AlphaLED/board/photos/v23.10.01/3d.png

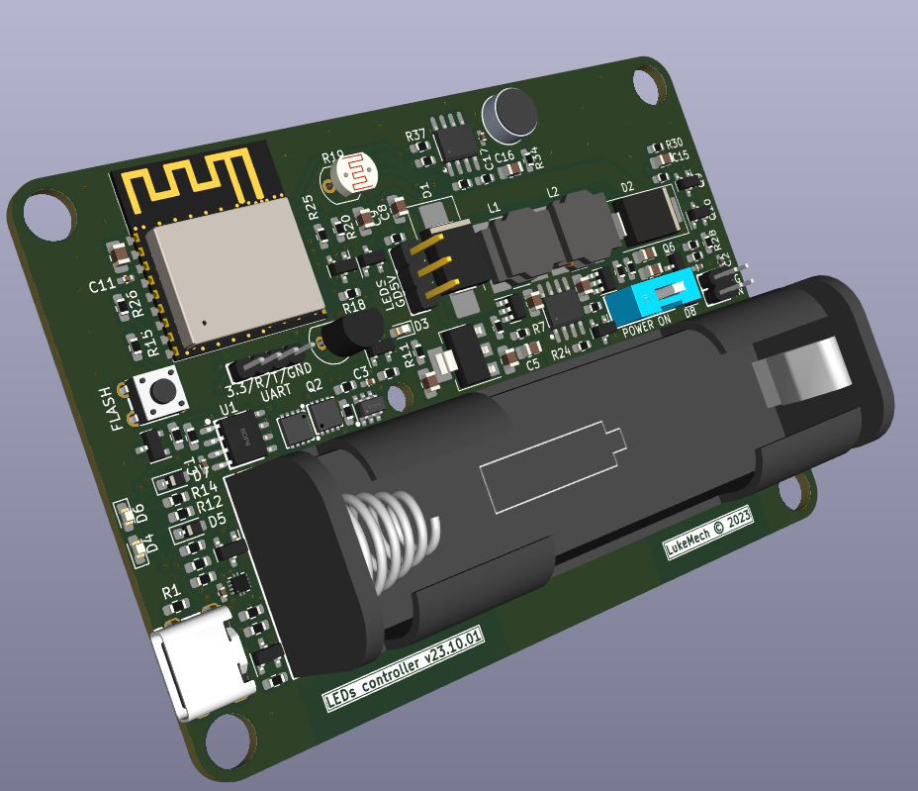
photos/v23.10.01/3d.png
