AlphaLED/board/photos/v23.10.01/board.png

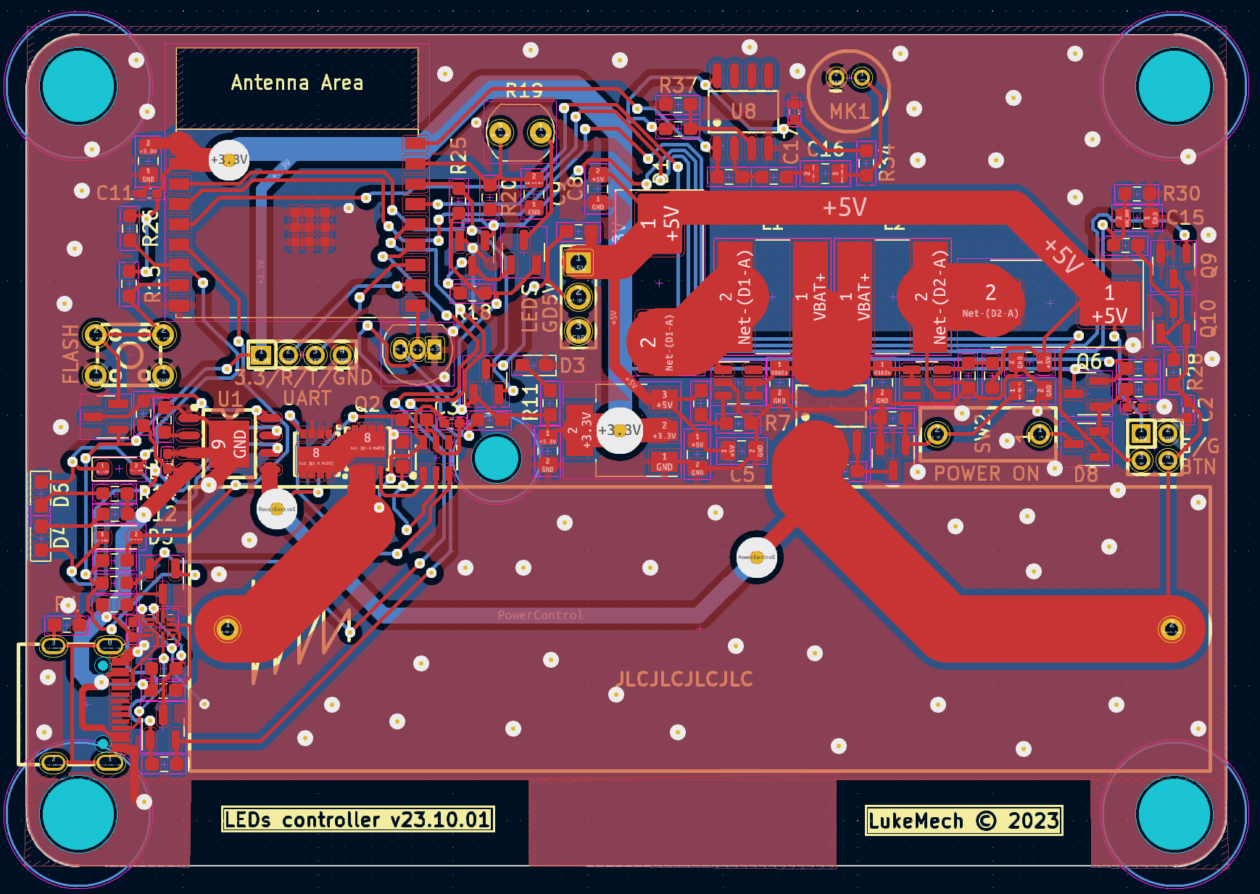
photos/v23.10.01/board.png
