AlphaLED/board/photos/v23.10.01/circuit.png

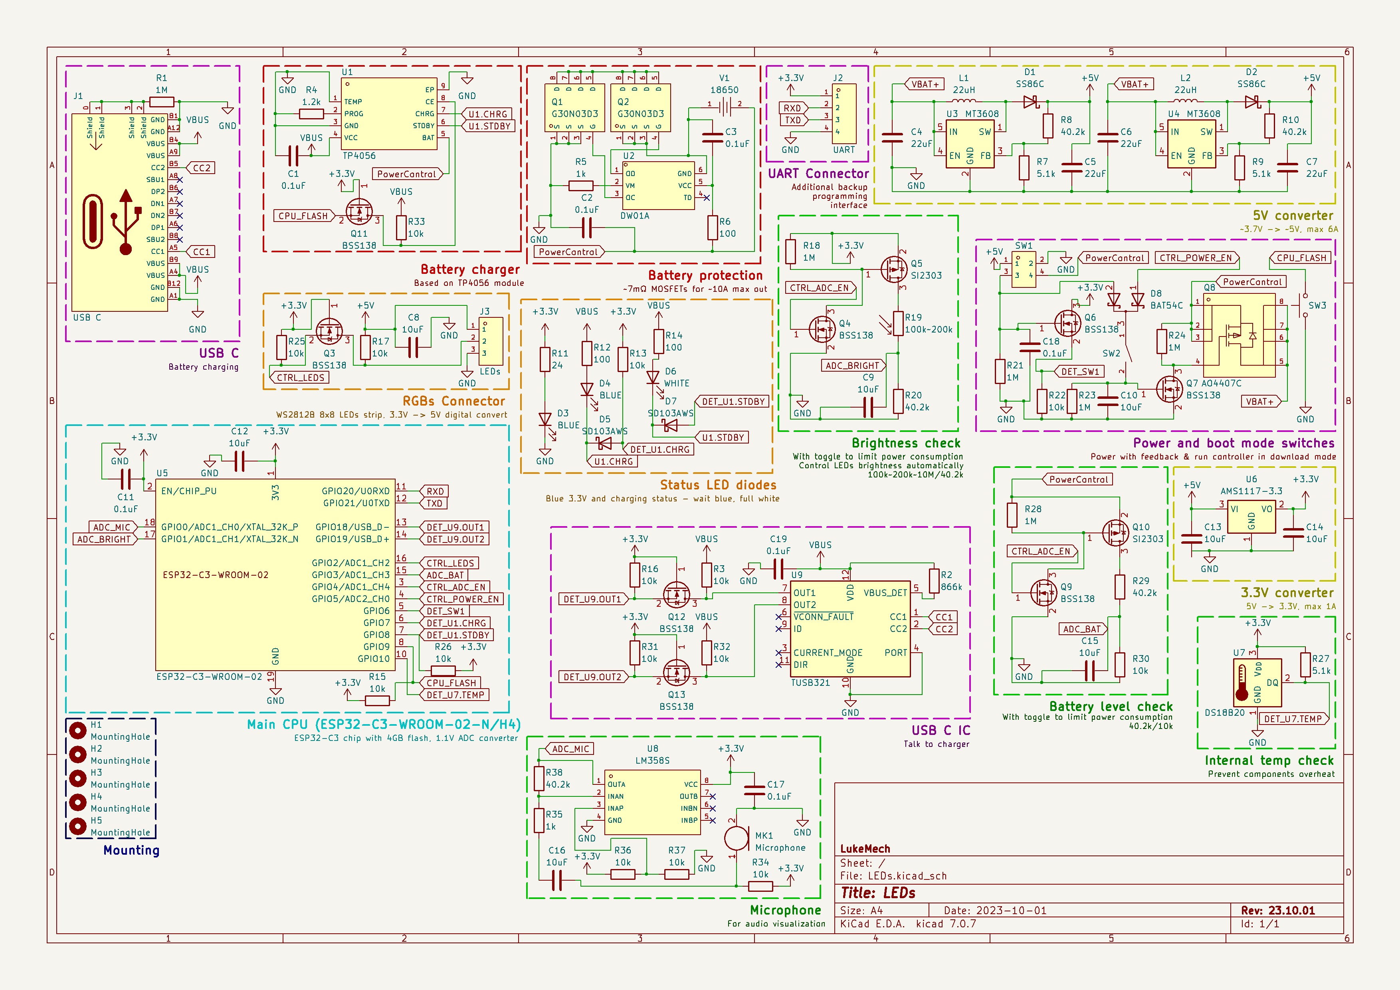
photos/v23.10.01/circuit.png
