AlphaLED/board/parts.xlsx

Name | Value | Amount | LCSC Number | Additional info | ! € -> PLN
Resistor | 1M | 6 | C103216 | - | 4.7
 | 866k | 1 | C5126056 | -
 | 40.2k | 5 | C12447 | - | ! JLCPCB total price (€)
 | 10k | 15 | C103210 | - | 41.07
 | 5.1k | 3 | C2907114 | -
 | 1.2k | 1 | C2907081 | - | ! LCSC total price (€)
 | 1k | 2 | C3016283 | - | 50
 | 100 | 3 | C3017758 | -
 | 24 | 1 | C3017772 | - | ! Price for amount
 | 100k~200k | 1 | C125631 | Photoresistor | 5
 | (FN) Sum | 38 | - | -
Capacitor | 22uF | 4 | C98190 | - | (FN) Calculated price per 1 (PLN)
 | 10uF | 8 | C1713 | - | 116.3558
 | 0.1uF | 7 | C344189 | -
 | (FN) Sum | 19
Inductors | 22uH | 2 | C2942298 | -
 | (FN) Sum | 2
Diodes | White | 1 | C965808 | -
 | Blue | 2 | C965807 | -
 | SS86C | 2 | C382823 | -
 | BAT54C | 1 | C2992451 | -
 | SD103AWS | 2 | C513472 | -
 | (FN)Sum | 8
MOSFET Transistors | G30N03D3 | 2 | C840054 | N-channel 30V 30A
 | BSS138 | 8 | C347484 | N-channel 50V 0.2A
 | SI2303 | 2 | C545575 | P-channel 30V 1.7A
 | AO4407C | 1 | C469397 | P-channel 30V 14A
 | (FN) Sum | 13
Logic boards | ESP32-C3 -WROOM | 1 | C2944070 | Main CPU
 | TP4056 | 1 | C7473158 | Battery charger IC
 | DW01A | 1 | C351410 | Battery protection IC
 | MT3608 | 2 | C2932326 | Voltage regulator -> FB 0.6*(1+R1/R2)
 | AMS1117-3.3 | 1 | C5181460 | 3.3V voltage regulator
 | DS18B20 | 1 | C5379069 | Temperature sensor
 | LM358S | 1 | C83902 | Dual amplifier
 | TUSB321 | 1 | C139392 | USB Type-C Configuration Channel IC
 | Condenser Microphone | 1 | C5160215 | Microphone
 | (FN) Sum | 10
Connectors | USB-C | 1 | C2927038 | -
 | 4pin UART | 1 | C541858 | -
 | 3pin LEDs | 1 | C429954 | -
 | 4pin power | 1 | C6332216 | -
 | Battery (18650) holder | 1 | C5290176 | -
Switches | DIP NC Power | 1 | C5299502 | -
 | Flash tactile switch | 1 | C5359331 | -
Third party | - | - | - | Price per unit (PLN)
 | Power button | 1 | - | 5
 | LEDs | 1 | - | 11.45
 | 18650 battery | 1 | - | 14.3
