AlphaLED/board/case/2-n.stl

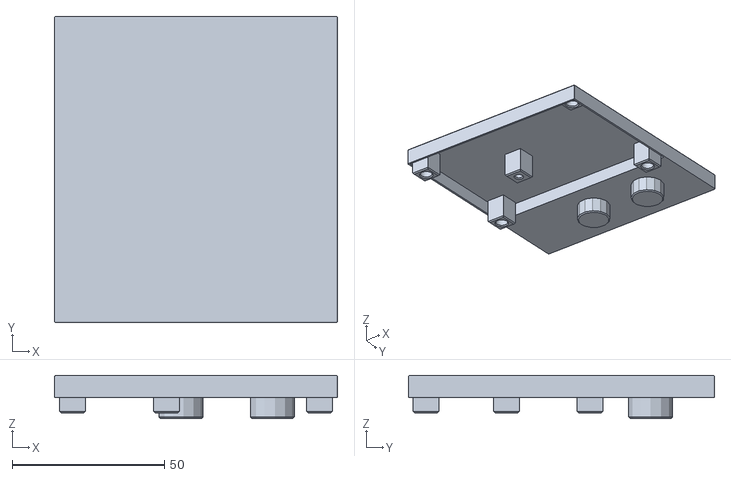
[picture p4: CAD file, 2023-10-01]
case/2-n.stl
93.0 x 100.7 x 14.2
