AlphaLED/board/case/1-n.stl

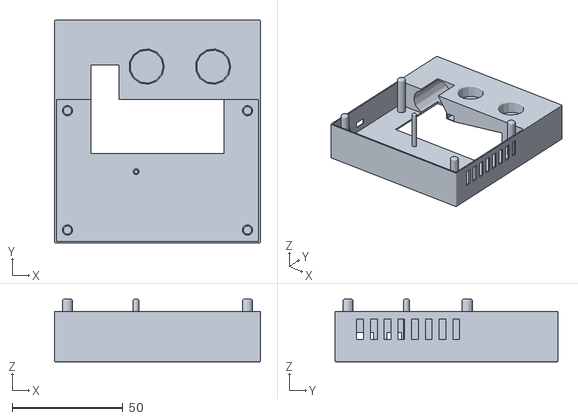
[picture p5: CAD file, 2023-10-01]
case/1-n.stl
93.0 x 100.7 x 28.3
