AlphaLED/board/LEDs.kicad_pcb

## KiCad design LEDs.kicad_pcb (2023-10-26)

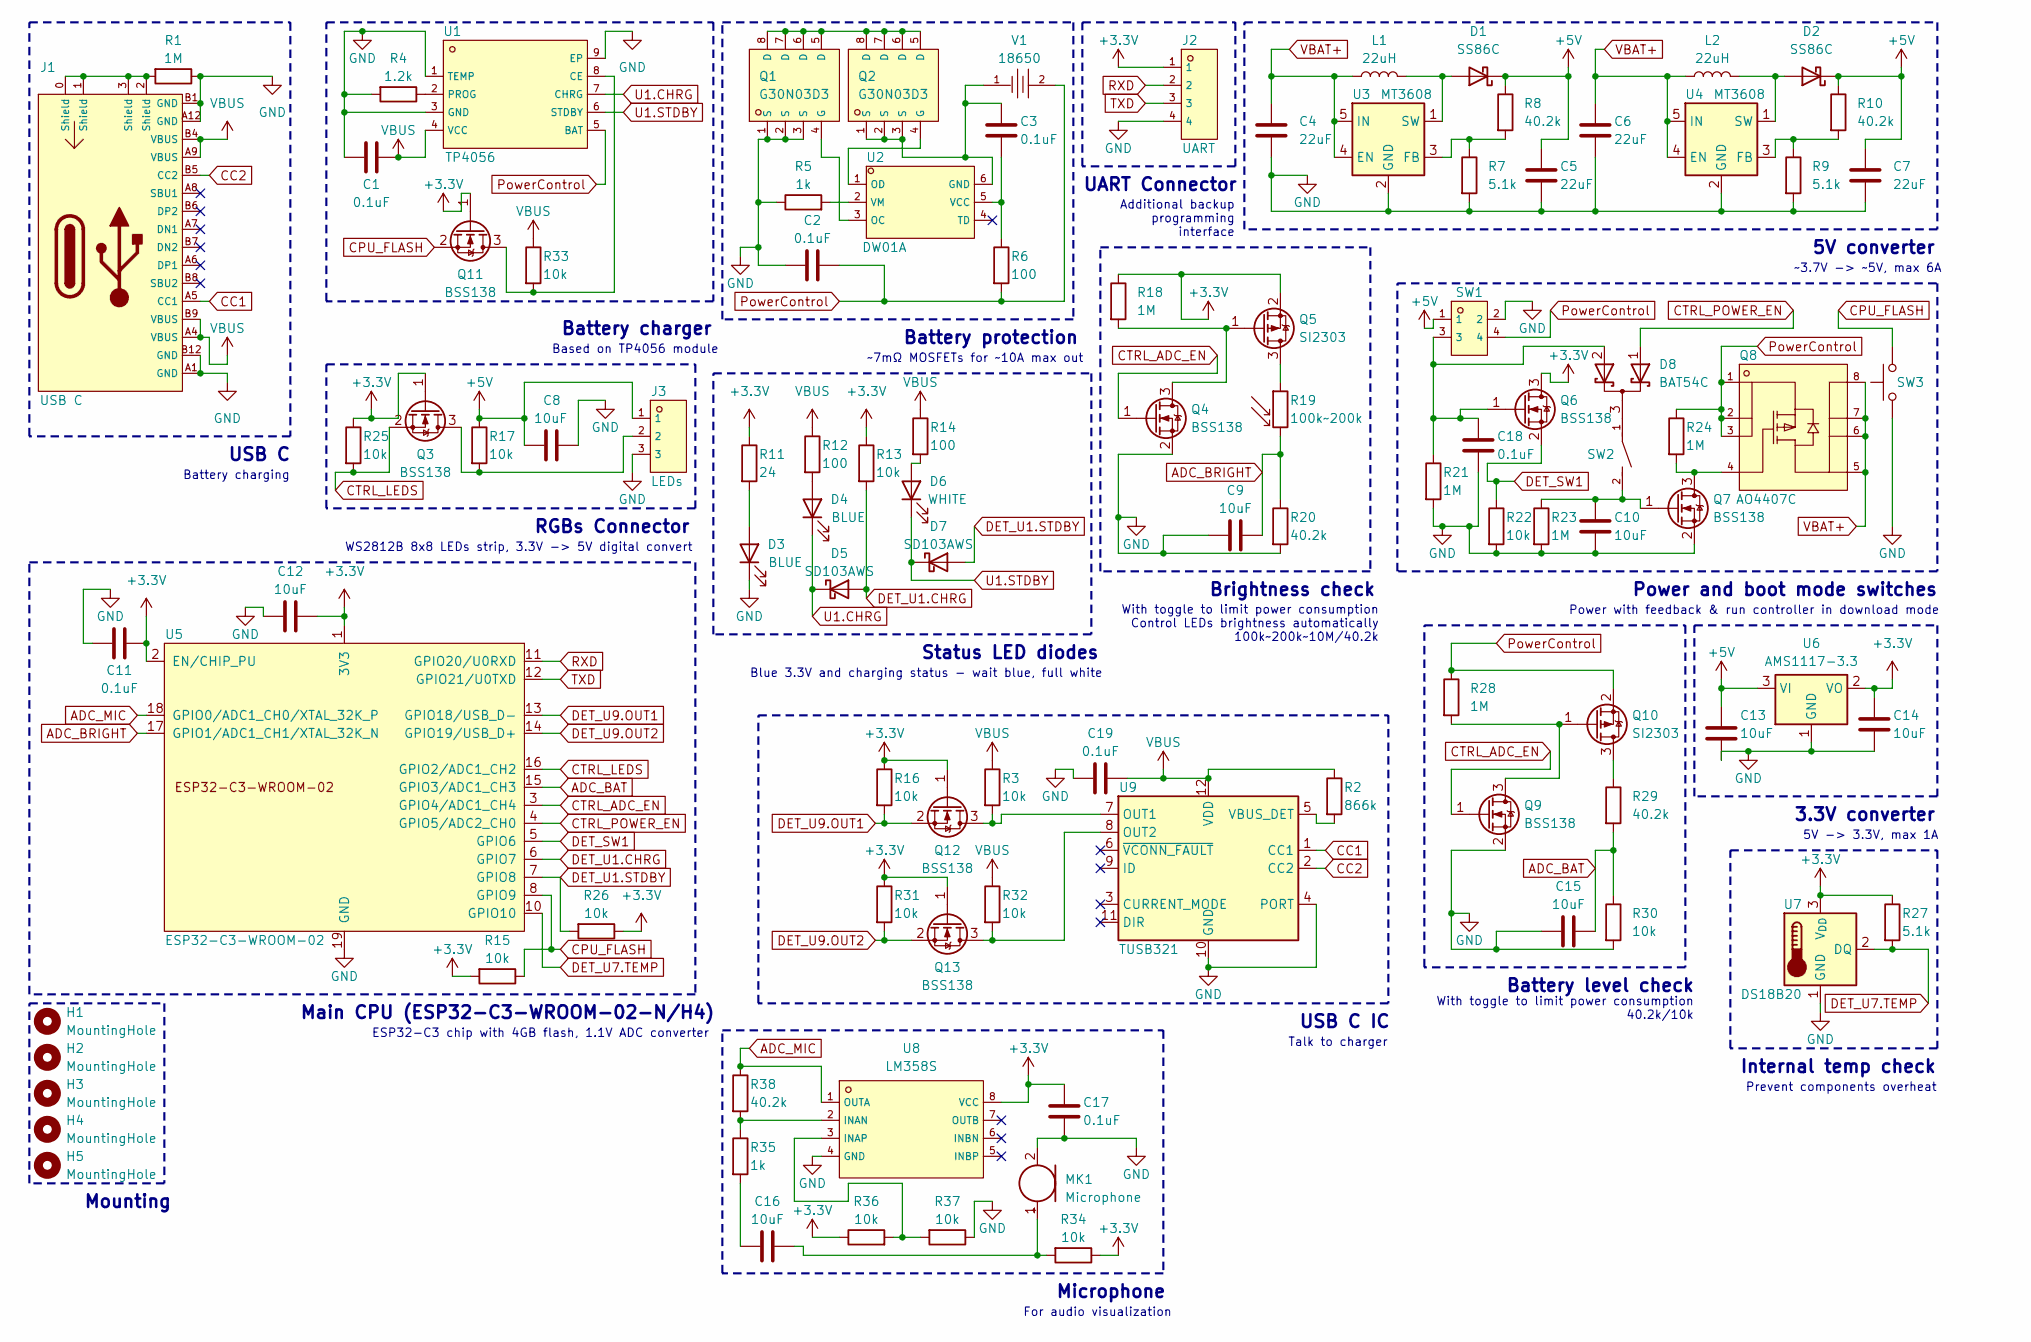
[picture p6: schematic LEDs.kicad_sch]

Parts:
C1, C2, C3, C11, C17, C18, C19: 0.1uF; C_0402_1005Metric_Pad0.74x0.62mm_HandSolder; LCSC C344189
C4, C5, C6, C7: 22uF; C_0805_2012Metric_Pad1.18x1.45mm_HandSolder; LCSC C98190
C8, C9, C10, C12, C13, C14, C15, C16: 10uF; C_0805_2012Metric_Pad1.18x1.45mm_HandSolder; LCSC C1713
D1, D2: SS86C; D_SMC_Handsoldering; LCSC C382823
D3, D4: BLUE; LED_0603_1608Metric_Pad1.05x0.95mm_HandSolder; LCSC C965807
D5, D7: SD103AWS; D_SOD-323_HandSoldering; LCSC C513472
D6: WHITE; LED_0603_1608Metric_Pad1.05x0.95mm_HandSolder; LCSC C965808
D8: BAT54C; SOT-23; LCSC C2992451
H1, H2, H3, H4: MountingHole; MountingHole_5.3mm_M5
H5: MountingHole; MountingHole_3.2mm_M3
J1: USB C; USB-C_SMD-TYPE-C-31-M-12; LCSC C2927038
J2: UART; HDR-TH_4P-P2.00-V-M; LCSC C541858
J3: LEDs; HDR-TH_3P-P2.54-V-M-1; LCSC C429954
L1, L2: 22uH; L_Bourns-SRN8040_8x8.15mm; LCSC C2942298
MK1: Microphone; MIC-TH_BD6.0_B6027AP383-056; LCSC C5160215
Q1, Q2: G30N03D3; POWERVDFN-8_L3.2-W3.1-P0.65-LS3.3-BL-1; LCSC C840054
Q3, Q4, Q6, Q7, Q9, Q11, Q12, Q13: BSS138; SOT-23; LCSC C347484
Q5, Q10: SI2303; SOT-23; LCSC C545575
Q8: AO4407C; SOP-8_L4.9-W3.9-P1.27-LS6.0-BL; LCSC C469397
R1, R18, R21, R23, R24, R28: 1M; R_0603_1608Metric_Pad0.98x0.95mm_HandSolder; LCSC C103216
R2: 866k; R_0603_1608Metric_Pad0.98x0.95mm_HandSolder; LCSC C5126056
R3, R13, R15, R16, R17, R22, R25, R26, R30, R31, R32, R33, R34, R36, R37: 10k; R_0603_1608Metric_Pad0.98x0.95mm_HandSolder; LCSC C103210
R4: 1.2k; R_0603_1608Metric_Pad0.98x0.95mm_HandSolder; LCSC C2907081
R5, R35: 1k; R_0603_1608Metric_Pad0.98x0.95mm_HandSolder; LCSC C3016283
R6, R12, R14: 100; R_0603_1608Metric_Pad0.98x0.95mm_HandSolder; LCSC C3017758
R7, R9, R27: 5.1k; R_0603_1608Metric_Pad0.98x0.95mm_HandSolder; LCSC C2907114
R8, R10, R20, R29, R38: 40.2k; R_0603_1608Metric_Pad0.98x0.95mm_HandSolder; LCSC C12447
R11: 24; R_0603_1608Metric_Pad0.98x0.95mm_HandSolder; LCSC C3017772
R19: 100k~200k; R_LDR_5.0x4.1mm_P3mm_Vertical; LCSC C125631
SW1: 4-pin; HDR-TH_4P-P2.00-V-M-R2-C2-S2.00; LCSC C6332216
SW2: SW-TH_KF1001-01P-B0-FL-ON-01B; LCSC C5299502
SW3: SW-TH_4P-L4.5-W4.5-P3.00-LS5.0; LCSC C5359331
U1: TP4056; SOP-8_L4.9-W3.9-P1.27-LS6.0-TL-EP; LCSC C7473158
U2: DW01A; SOT-23-6_L2.9-W1.6-P0.95-LS2.8-BL; LCSC C351410
U3, U4: MT3608; SOT-23-6; LCSC C2932326
U5: ESP32-C3-WROOM-02; LCSC C2944070
U6: AMS1117-3.3; SOT-223-3_TabPin2; LCSC C5181460
U7: DS18B20; TO-92_Inline; LCSC C5379069
U8: LM358S; SOP-8_L4.9-W3.9-P1.27-LS6.0-BL; LCSC C83902
U9: TUSB321; Texas_X2QFN-12_1.6x1.6mm_P0.4mm; LCSC C139392
V1: 18650; BAT-TH_BH-18650-A1AJ005; LCSC C5290176

Connections:
+3.3V: C11.2, C12.2, C14.1, C17.1, J2.1, Q3.1 (G), Q5.2 (S), Q6.3 (D), Q11.1 (G), Q12.1 (G), Q13.1 (G), R11.1, R13.1, R15.2, R16.1, R18.1, R25.1, R26.1, R27.1, R31.1, R34.1, R36.1, U5.1 (3V3), U5.2 (EN/CHIP_PU), U6.2 (VO), U7.3 (V_{DD}), U8.8 (VCC)
+5V: C5.1, C7.1, C8.2, C13.1, D1.1 (K), D2.1 (K), J3.1, R8.1, R10.1, R17.1, SW1.1, U6.3 (VI)
ADC_BAT: C15.2, R29.2, R30.1, U5.15 (GPIO3/ADC1_CH3)
ADC_BRIGHT: C9.2, R19.2, R20.1, U5.17 (GPIO1/ADC1_CH1/XTAL_32K_N)
ADC_MIC: R38.1, U5.18 (GPIO0/ADC1_CH0/XTAL_32K_P), U8.1 (OUTA)
CC1: J1.A5 (CC1), U9.1 (CC1)
CC2: J1.B5 (CC2), U9.2 (CC2)
CTRL_ADC_EN: Q4.1 (G), Q9.1 (G), U5.3 (GPIO4/ADC1_CH4)
CTRL_LEDS: Q3.2 (S), R25.2, U5.16 (GPIO2/ADC1_CH2)
CTRL_POWER_EN: D8.1 (K), U5.4 (GPIO5/ADC2_CH0)
DET_SW1: Q6.2 (S), R22.1, U5.5 (GPIO6)
DET_U1.CHRG: D5.2 (A), R13.2, U5.6 (GPIO7)
DET_U1.STDBY: D7.2 (A), R26.2, U5.7 (GPIO8)
DET_U7.TEMP: R27.2, U5.10 (GPIO10), U7.2 (DQ)
DET_U9.OUT1: Q12.2 (S), R16.2, U5.13 (GPIO18/USB_D-)
DET_U9.OUT2: Q13.2 (S), R31.2, U5.14 (GPIO19/USB_D+)
unnamed: C16.2, R35.2
unnamed: D1.2 (A), L1.2, U3.1 (SW)
unnamed: D2.2 (A), L2.2, U4.1 (SW)
unnamed: D3.2 (A), R11.2
unnamed: D4.2 (A), R12.2
unnamed: D6.2 (A), R14.2
unnamed: D8.3 (A), SW2.1
unnamed: J1.0 (Shield), J1.1 (Shield), J1.2 (Shield), J1.3 (Shield), R1.2
unnamed: C16.1, MK1.1 (+), R34.2
unnamed: Q1.5 (D), Q1.6 (D), Q1.7 (D), Q1.8 (D), Q2.5 (D), Q2.6 (D), Q2.7 (D), Q2.8 (D)
unnamed: Q1.4 (G), U2.3 (OC)
unnamed: Q2.4 (G), U2.1 (OD)
unnamed: J3.2, Q3.3 (D), R17.2
unnamed: Q4.3 (D), Q5.1 (G), R18.2
unnamed: Q5.3 (D), R19.1
unnamed: C18.1, D8.2 (K), Q6.1 (G), R21.1, SW1.3
unnamed: Q7.3 (D), Q8.4 (G), R24.2
unnamed: C10.1, Q7.1 (G), R23.1, SW2.2
unnamed: Q10.3 (D), R29.1
unnamed: Q9.3 (D), Q10.1 (G), R28.2
unnamed: Q11.3 (D), R33.2, U1.8 (CE)
unnamed: Q12.3 (D), R3.2, U9.7 (OUT1)
unnamed: Q13.3 (D), R32.2, U9.8 (OUT2)
unnamed: R4.1, U1.2 (PROG)
unnamed: C3.1, Q2.1 (S), Q2.2 (S), Q2.3 (S), U2.6 (GND), V1.1
unnamed: C3.2, R6.1, U2.5 (VCC)
unnamed: R5.2, U2.2 (VM)
unnamed: R7.1, R8.2, U3.3 (FB)
unnamed: R9.1, R10.2, U4.3 (FB)
unnamed: R35.1, R38.2, U8.2 (INAN)
unnamed: R36.2, R37.2, U8.3 (INAP)
unnamed: R2.2, U9.5 (VBUS_DET)
PowerControl: C2.2, Q8.1 (S), Q8.2 (S), Q8.3 (S), Q10.2 (S), R6.2, R24.1, R28.1, SW1.4, U1.5 (BAT), V1.2
RXD: J2.2, U5.11 (GPIO20/U0RXD)
TXD: J2.3, U5.12 (GPIO21/U0TXD)
U1.CHRG: D4.1 (K), D5.1 (K), U1.7 (CHRG)
U1.STDBY: D6.1 (K), D7.1 (K), U1.6 (STDBY)
VBAT+: C4.1, C6.1, L1.1, L2.1, Q8.5 (D), Q8.6 (D), Q8.7 (D), Q8.8 (D), U3.4 (EN), U3.5 (IN), U4.4 (EN), U4.5 (IN)
VBUS: C1.2, C19.2, J1.A4 (VBUS), J1.A9 (VBUS), J1.B4 (VBUS), J1.B9 (VBUS), R2.1, R3.1, R12.1, R14.1, R32.1, R33.1, U1.4 (VCC), U9.12 (VDD)

Notes on the sheet:
Internal temp check
With toggle to limit power consumption Control LEDs brightness automatically 100k~200k~10M/40.2k
USB C
Battery level check
Prevent components overheat
Power with feedback & run controller in download mode
Main CPU (ESP32-C3-WROOM-02-N/H4)
Brightness check
Microphone
Blue 3.3V and charging status - wait blue, full white
WS2812B 8x8 LEDs strip, 3.3V -> 5V digital convert
3.3V converter
RGBs Connector
Battery protection
Status LED diodes
Talk to charger
5V -> 3.3V, max 1A
Battery charging
~7mΩ MOSFETs for ~10A max out
ESP32-C3 chip with 4GB flash, 1.1V ADC converter
Mounting
USB C IC
Power and boot mode switches
5V converter
Battery charger
Based on TP4056 module
UART Connector
Additional backup programming interface
~3.7V -> ~5V, max 6A
With toggle to limit power consumption 40.2k/10k
For audio visualization

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
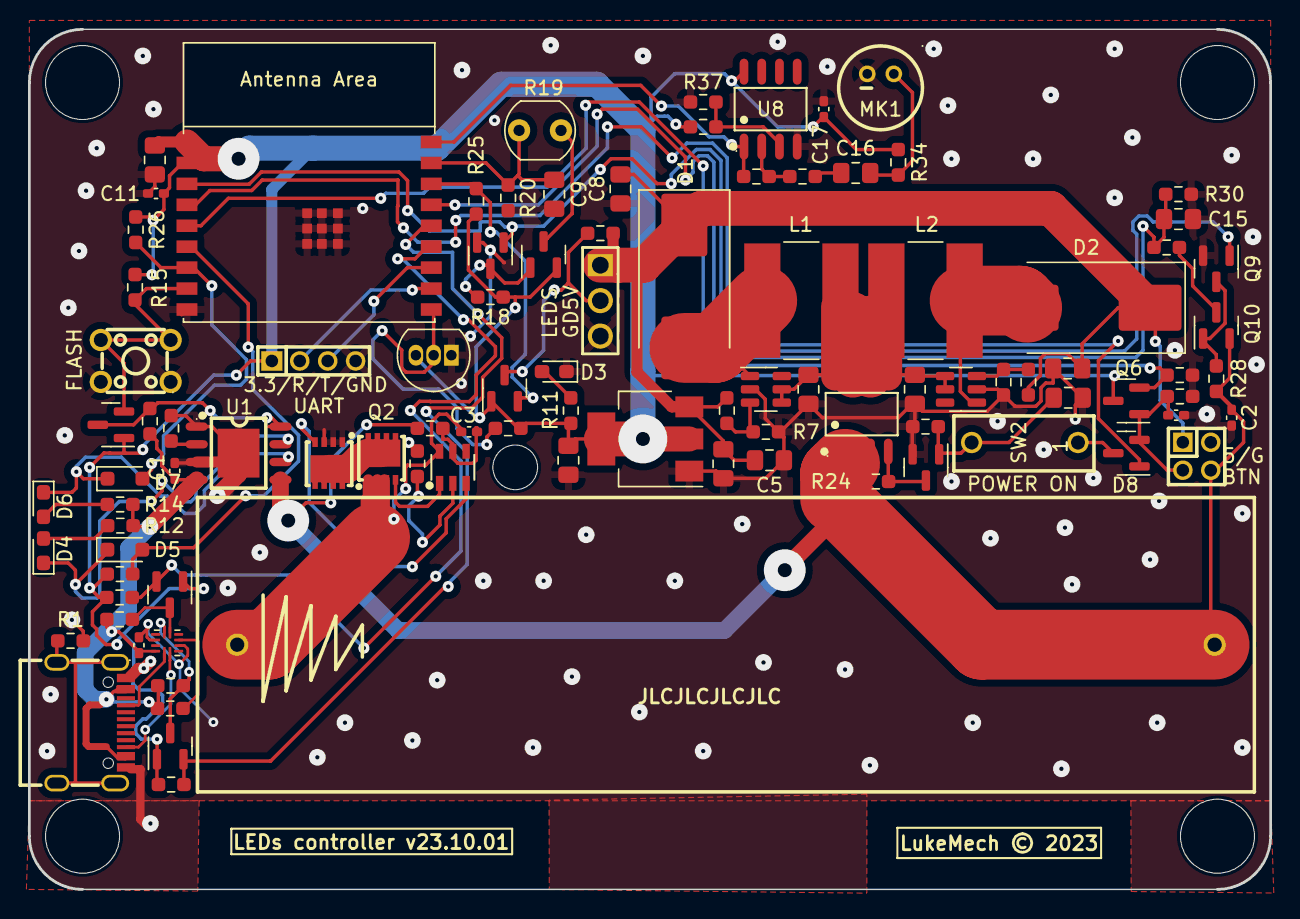
[picture p7: board LEDs.kicad_pcb from above]

Board: 2 copper layers, 88.9 x 61.6 mm, 102 parts (0 on the bottom side), 57 nets.
