AlphaLED/board/(commit log)

2023-10-01 Modified case design
    [Whole-n.cfg]
2023-10-01 Rename board ver, add photos
    [LEDs-CuBottom.gbr, LEDs-CuTop.gbr, LEDs-EdgeCuts.gbr, LEDs-MaskBottom.gbr, LEDs-MaskTop.gbr, LEDs-NPTH.drl, LEDs-PTH.drl, LEDs-PasteBottom.gbr]
2023-10-01 Small resistor change
    [1-n.stl, 1.3mf, 2-n.stl, 2.3mf, BOM-LEDs.csv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]
