AlphaLED/board/(notices)

Notices in the files:
LEDs.kicad_pcb:
LukeMech © 2023
